kglavin/iot/iotkong/datasheets/XiuxinESP8266.jpg

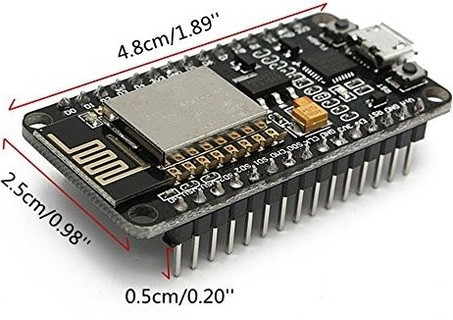
iotkong/datasheets/XiuxinESP8266.jpg
