kglavin/iot/README.md

# iot
various pieces of iot experimentation including
* micropython
* esp8266 featherboard
