kglavin/iot/micropython/network/README.md

 simple socket based client to get a list of web pages
