kglavin/iot/iotkong/iotkong.kicad_pcb

## KiCad design iotkong/iotkong.kicad_pcb (2018-09-19)

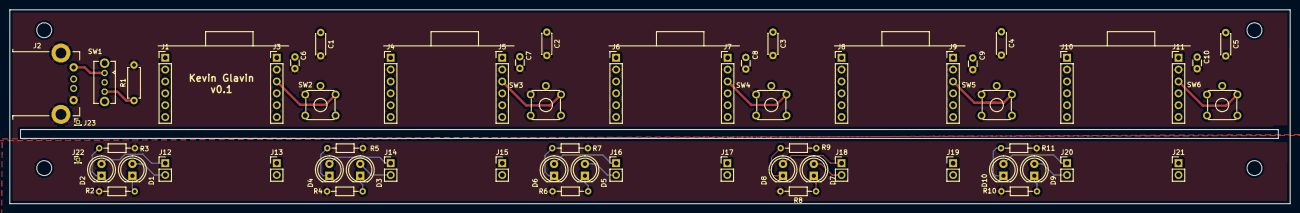
[picture p2: board iotkong.kicad_pcb from above]

Board: 2 copper layers, 274.1 x 41.5 mm, 64 parts (0 on the bottom side), 29 nets.

Parts:
C1, C2, C3, C4, C5: 47uF; C_Disc_D4.3mm_W1.9mm_P5.00mm
C6, C7, C8, C9, C10: 0.1uF; C_Disc_D3.0mm_W1.6mm_P2.50mm
D1, D2, D3, D4, D5, D6, D7, D8, D9, D10: LED; LED_D5.0mm
J1, J3, J4, J5, J6, J7, J8, J9, J10, J11: Conn_01x06_Female; PinHeader_1x06_P2.54mm_Vertical
J2: USB_B; USB_2_0
J12, J13, J14, J15, J16, J17, J18, J19, J20, J21: Conn_01x06_Female; PinHeader_1x02_P2.54mm_Vertical
J22, J23: Conn_01x01_Female; PinHeader_1x01_P1.00mm_Vertical
MH1, MH2, MH3, MH4: MountingHole; MountingHole_3.2mm_M3_ISO7380
R1: 100; R_Axial_DIN0207_L6.3mm_D2.5mm_P7.62mm_Horizontal
R2, R3, R4, R5, R6, R7, R8, R9, R10, R11: 100; R_Axial_DIN0204_L3.6mm_D1.6mm_P7.62mm_Horizontal
SW1: SW_Push_SPDT; CKN10397-ND
SW2, SW3, SW4, SW5, SW6: SW_SPST; SW_TH_Tactile_Omron_B3F-10xx

Connections:
GND: C1.2, C2.2, C3.2, C4.2, C5.2, C6.2, C7.2, C8.2, C9.2, C10.2, J1.2, J2.4, J2.5, J3.2, J4.2, J5.2, J6.2, J7.2, J8.2, J9.2, J10.2, J11.2, J22.1, J23.1, R1.2, R2.2, R3.2, R4.2, R5.2, R6.2, R7.2, R8.2, R9.2, R10.2, R11.2, SW2.1, SW3.1, SW4.1, SW5.1, SW6.1
LED1: D2.2, J12.1
LED2: D1.2, J12.2
LED3: D4.2, J14.1
LED4: D3.2, J14.2
LED5: D6.2, J16.1
LED6: D5.2, J16.2
LED7: D8.2, J18.1
LED8: D7.2, J18.2
LED9: D10.2, J20.1
LED10: D9.2, J20.2
unnamed: D1.1, R2.1
unnamed: D2.1, R3.1
unnamed: D3.1, R4.1
unnamed: D4.1, R5.1
unnamed: D5.1, R6.1
unnamed: D6.1, R7.1
unnamed: D7.1, R8.1
unnamed: D8.1, R9.1
unnamed: D9.1, R10.1
unnamed: D10.1, R11.1
unnamed: J2.1, SW1.1
unnamed: J3.3, SW2.2
unnamed: J5.3, SW3.2
unnamed: J7.3, SW4.2
unnamed: J9.3, SW5.2
unnamed: J11.3, SW6.2
unnamed: R1.1, SW1.3
VCC: C1.1, C2.1, C3.1, C4.1, C5.1, C6.1, C7.1, C8.1, C9.1, C10.1, J3.1, J5.1, J7.1, J9.1, J11.1, SW1.2
