kglavin/iot/micropython/network/boot.py

# This file is executed on every boot (including wake-boot from deepsleep)
#import esp
#esp.osdebug(None)
import gc
import webrepl
webrepl.start()
gc.collect()

def do_connect():
    import network
    sta_if = network.WLAN(network.STA_IF)
    if not sta_if.isconnected():
        print('connecting to network...')
        sta_if.active(True)
        sta_if.connect('iot', 'iot')
        while not sta_if.isconnected():
            pass
    print('network config:', sta_if.ifconfig())

do_connect()
