kglavin/iot/(commit log)

2018-09-01 basic fake stats from iot device via http post
2018-09-08 first cut at multi module board
    [iotkong.kicad_pcb, iotkong.sch]
2018-09-08 running on other 8266 board, runing the job_machine also
2018-09-08 pipout for hiletgo -703681358704 board
2018-09-09 0.98 alignment for board
    [iotkong.kicad_pcb, iotkong.sch]
2018-09-09 runnable on micropython and a second device id
2018-09-11 added leds and board pinout details
    [2018-09-10T210741.csv, iotkong.sch]
2018-09-12 added leds and placed
    [iotkong.kicad_pcb, iotkong.sch]
2018-09-13 fixed switches
    [iotkong-B.Cu.gbr, iotkong-B.Mask.gbr, iotkong-B.Paste.gbr, iotkong-B.SilkS.gbr, iotkong-Edge.Cuts.gbr, iotkong-F.Cu.gbr, iotkong-F.Mask.gbr, iotkong-F.Paste.gbr]
2018-09-14 updated foorprints
    [iotkong-B.Cu.gbr, iotkong-B.Fab.gbr, iotkong-B.Mask.gbr, iotkong-B.Paste.gbr, iotkong-Edge.Cuts.gbr, iotkong-F.Cu.gbr, iotkong-F.Fab.gbr, iotkong-F.Mask.gbr]
2018-09-19 seperated board to top and bottom
    [iotkong.kicad_pcb, iotkong.sch]
